Cosmin2106/xmas-drawboard/cad/case/FrontPlate.FCStd

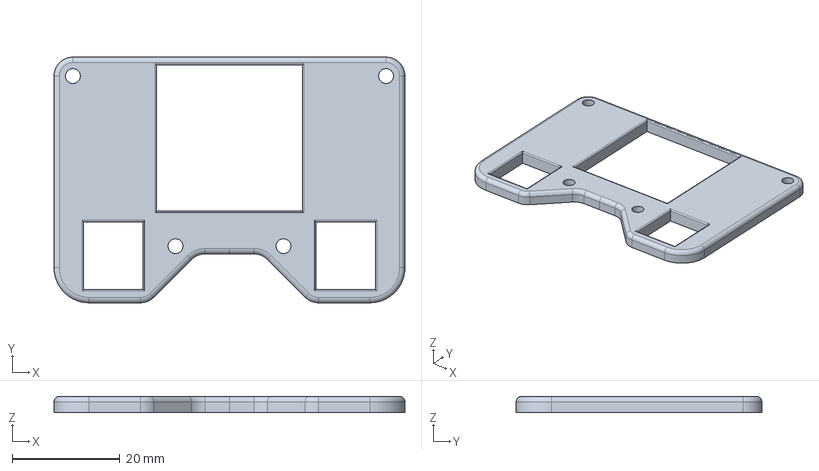
[picture p1: CAD file, 2026-11-04]
cad/case/FrontPlate.FCStd
65.0 x 45.5 x 3.00 mm
