Cosmin2106/xmas-drawboard/cad/case/BackPlate.FCStd

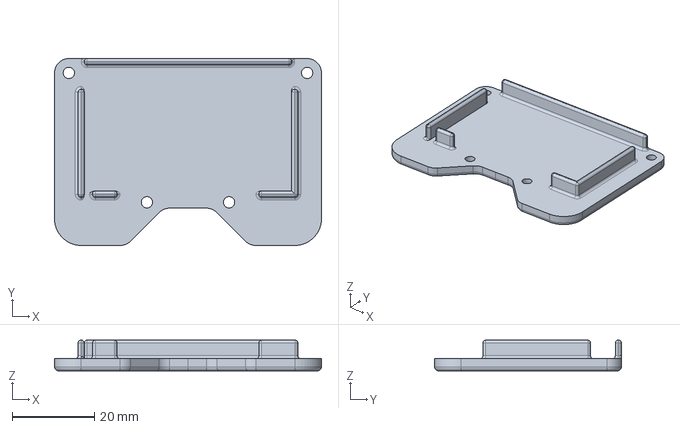
[picture p2: CAD file, 2026-11-04]
cad/case/BackPlate.FCStd
65.0 x 45.5 x 7.50 mm
