Cosmin2106/xmas-drawboard/cad/board/board.kicad_pcb

## KiCad design cad/board/board.kicad_pcb (2026-11-04)

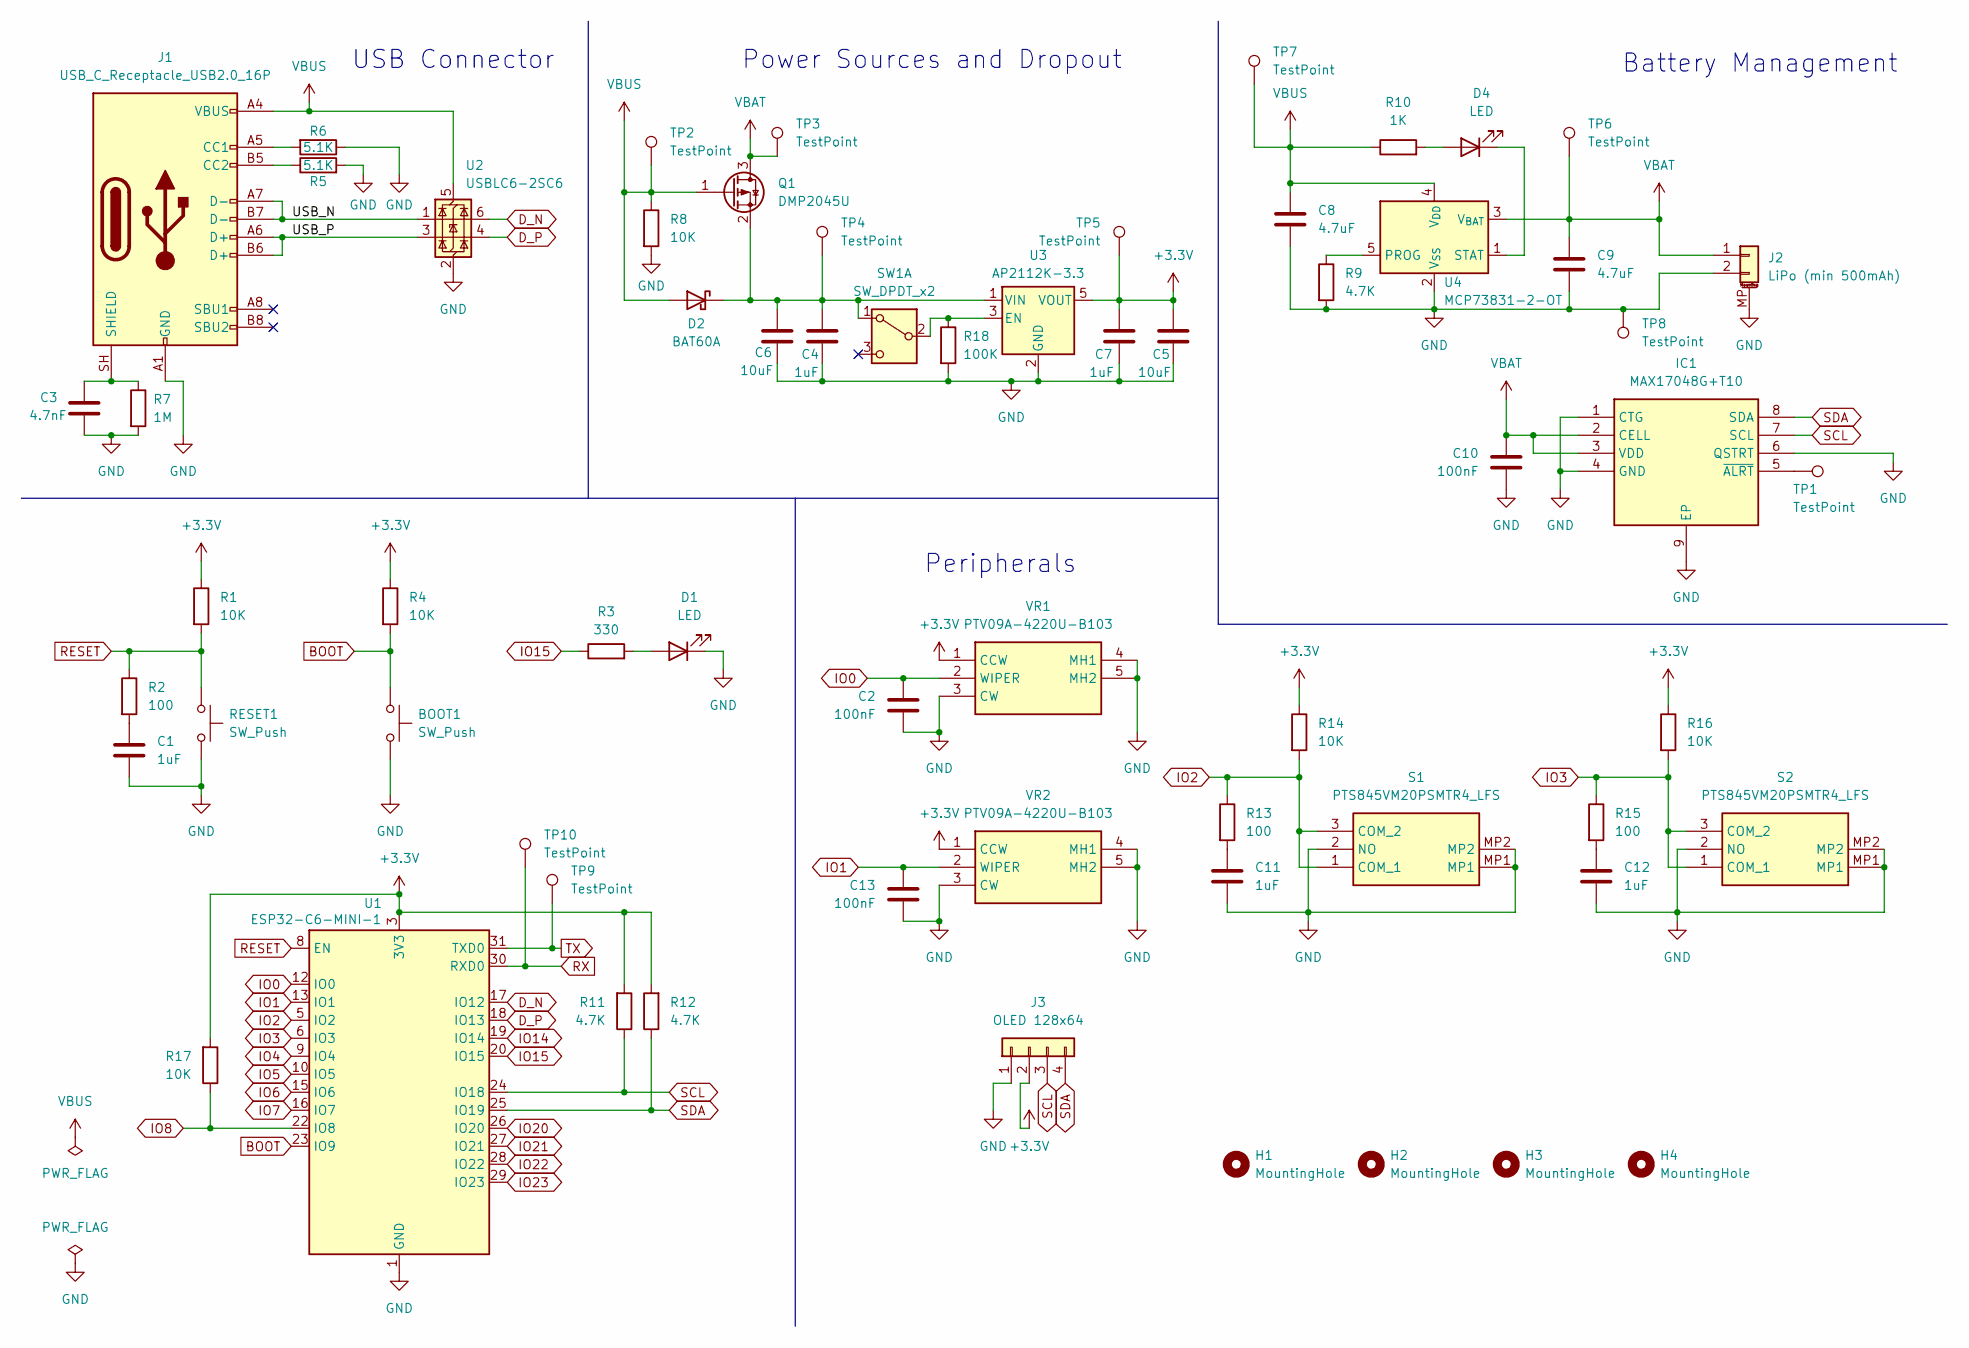
[picture p3: schematic board.kicad_sch, ESP32C6 Drawboard]

Parts:
BOOT1: SW_Push; SW_Push_1P1T_NO_CK_KMR2
C1, C4, C7, C11, C12: 1uF; C_0603_1608Metric
C2, C10, C13: 100nF; C_0603_1608Metric
C3: 4.7nF; C_0603_1608Metric
C5, C6: 10uF; C_0603_1608Metric
C8, C9: 4.7uF; C_0603_1608Metric
D1, D4: LED; LED_0603_1608Metric
D2: BAT60A; D_SOD-323
H1, H2, H3, H4: MountingHole; RPi_Mounting_Hole
IC1: MAX17048G+T10; SON50P200X200X80-9N-D; Mouser Part Number 700-MAX17048G+T10
J1: USB_C_Receptacle_USB2.0_16P; USB_C_Receptacle_GCT_USB4105-xx-A_16P_TopMnt_Horizontal
J2: LiPo (min 500mAh); JST_PH_S2B-PH-SM4-TB_1x02-1MP_P2.00mm_Horizontal
J3: OLED 128x64; OLED_128x64_I2C_BOARD
Q1: DMP2045U; TSOT-23
R1, R4, R8, R14, R16, R17: 10K; R_0603_1608Metric
R2, R13, R15: 100; R_0603_1608Metric
R3: 330; R_0603_1608Metric
R5, R6: 5.1K; R_0603_1608Metric
R7: 1M; R_0603_1608Metric
R9, R11, R12: 4.7K; R_0603_1608Metric
R10: 1K; R_0603_1608Metric
R18: 100K; R_0603_1608Metric
RESET1: SW_Push; SW_Push_1P1T_NO_CK_KMR2
S1, S2: PTS845VM20PSMTR4_LFS; PTS845VM20PSMTR4LFS; Manufacturer_Part_Number PTS845VM20PSMTR4 LFS
SW1: SW_DPDT_x2; SW_SPDT_CK_JS102011SAQN
TP1, TP2, TP3, TP4, TP5, TP6, TP7, TP8, TP9, TP10: TestPoint; TestPoint_Pad_D1.5mm
U1: ESP32-C6-MINI-1
U2: USBLC6-2SC6; SOT-23-6
U3: AP2112K-3.3; SOT-23-5
U4: MCP73831-2-OT; SOT-23-5
VR1, VR2: PTV09A-4220U-B103; PTV09A4220FB103; Mouser Part Number 652-PTV09A-4220FB103

Connections:
+3.3V: C5.1, C7.1, J3.2, R1.1, R4.1, R11.2, R12.2, R14.1, R16.1, R17.2, TP5.1 (1_1), U1.3 (3V3), U3.5 (VOUT), VR1.1 (CCW), VR2.1 (CCW)
/USB_N: J1.A7 (D-), J1.B7 (D-), U2.1 (I/O1)
/USB_P: J1.A6 (D+), J1.B6 (D+), U2.3 (I/O2)
BOOT: BOOT1.1, R4.2, U1.23 (IO9)
D_N: U1.17 (IO12), U2.6 (I/O1)
D_P: U1.18 (IO13), U2.4 (I/O2)
GND: BOOT1.2, C1.2, C2.2, C3.2, C4.2, C5.2, C6.2, C7.2, C8.1, C9.1, C10.2, C11.2, C12.2, C13.2, D1.1 (K), IC1.1 (CTG), IC1.4 (GND), IC1.6 (QSTRT), IC1.9 (EP), J1.A1 (GND), J1.A12 (GND), J1.B1 (GND), J1.B12 (GND), J2.2, J2.MP (MountPin), J3.1, R5.2, R6.1, R7.2, R8.2, R9.2, R18.2, RESET1.2, S1.2 (NO), S1.MP1, S1.MP2, S2.2 (NO), S2.MP1, S2.MP2, TP8.1 (1_1), U1.1 (GND), U1.2 (GND), U1.11 (GND), U1.14 (GND), U1.36 (GND), U1.37 (GND), U1.38 (GND), U1.39 (GND), U1.40 (GND), U1.41 (GND), U1.42 (GND), U1.43 (GND), U1.44 (GND), U1.45 (GND), U1.46 (GND), U1.47 (GND), U1.48 (GND), U1.49 (GND), U1.50 (GND), U1.51 (GND), U1.52 (GND), U1.53 (GND), U2.2 (GND), U3.2 (GND), U4.2 (V_{SS}), VR1.3 (CW), VR1.4 (MH1), VR1.5 (MH2), VR2.3 (CW), VR2.4 (MH1), VR2.5 (MH2)
IO0: C2.1, U1.12 (IO0), VR1.2 (WIPER)
IO1: C13.1, U1.13 (IO1), VR2.2 (WIPER)
IO2: R13.1, R14.2, S1.1 (COM_1), S1.3 (COM_2), U1.5 (IO2)
IO3: R15.1, R16.2, S2.1 (COM_1), S2.3 (COM_2), U1.6 (IO3)
IO4: U1.9 (IO4)
IO5: U1.10 (IO5)
IO6: U1.15 (IO6)
IO7: U1.16 (IO7)
IO8: R17.1, U1.22 (IO8)
IO14: U1.19 (IO14)
IO15: R3.1, U1.20 (IO15)
IO20: U1.26 (IO20)
IO21: U1.27 (IO21)
IO22: U1.28 (IO22)
IO23: U1.29 (IO23)
unnamed: C1.1, R2.2
unnamed: C11.1, R13.2
unnamed: C12.1, R15.2
unnamed: D1.2 (A), R3.2
unnamed: C4.1, C6.1, D2.1 (K), Q1.2 (S), SW1.1 (A), TP4.1 (1_1), U3.1 (VIN)
unnamed: D4.2 (A), R10.2
unnamed: D4.1 (K), U4.1 (STAT)
unnamed: IC1.5 (~ALRT), TP1.1 (1_1)
unnamed: J1.A5 (CC1), R6.2
unnamed: J1.B5 (CC2), R5.1
unnamed: C3.1, J1.SH (SHIELD), R7.1
unnamed: R18.1, SW1.2 (B), U3.3 (EN)
unnamed: R9.1, U4.5 (PROG)
RESET: R1.2, R2.1, RESET1.1, U1.8 (EN)
RX: TP10.1 (1_1), U1.30 (RXD0)
SCL: IC1.7 (SCL), J3.3, R11.1, U1.24 (IO18)
SDA: IC1.8 (SDA), J3.4, R12.1, U1.25 (IO19)
TX: TP9.1 (1_1), U1.31 (TXD0)
VBAT: C9.2, C10.1, IC1.2 (CELL), IC1.3 (VDD), J2.1, Q1.3 (D), TP3.1 (1_1), TP6.1 (1_1), U4.3 (V_{BAT})
VBUS: C8.2, D2.2 (A), J1.A4 (VBUS), J1.A9 (VBUS), J1.B4 (VBUS), J1.B9 (VBUS), Q1.1 (G), R8.1, R10.1, TP2.1 (1_1), TP7.1 (1_1), U2.5 (VBUS), U4.4 (V_{DD})

Notes on the sheet:
USB Connector
Battery Management
Power Sources and Dropout
Peripherals

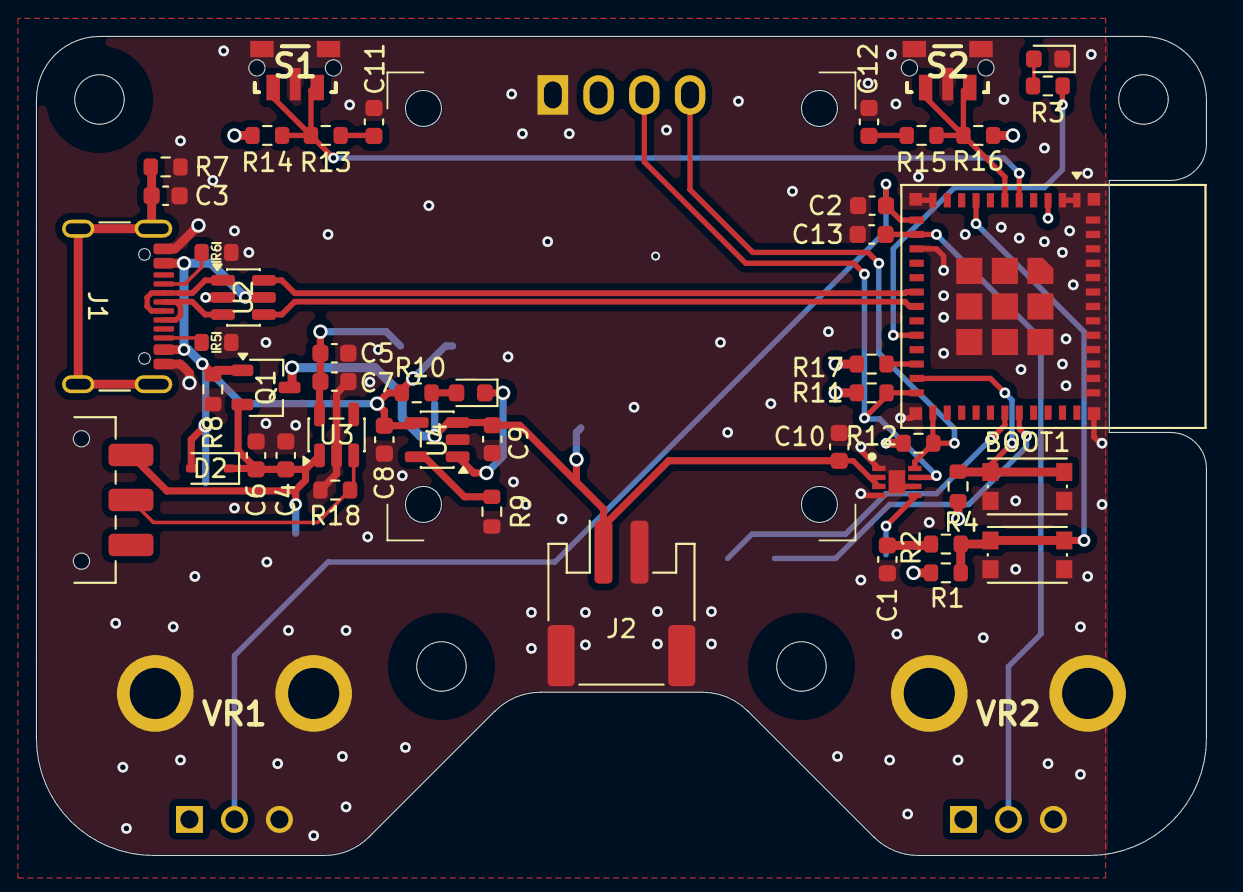
[picture p4: board board.kicad_pcb from above]

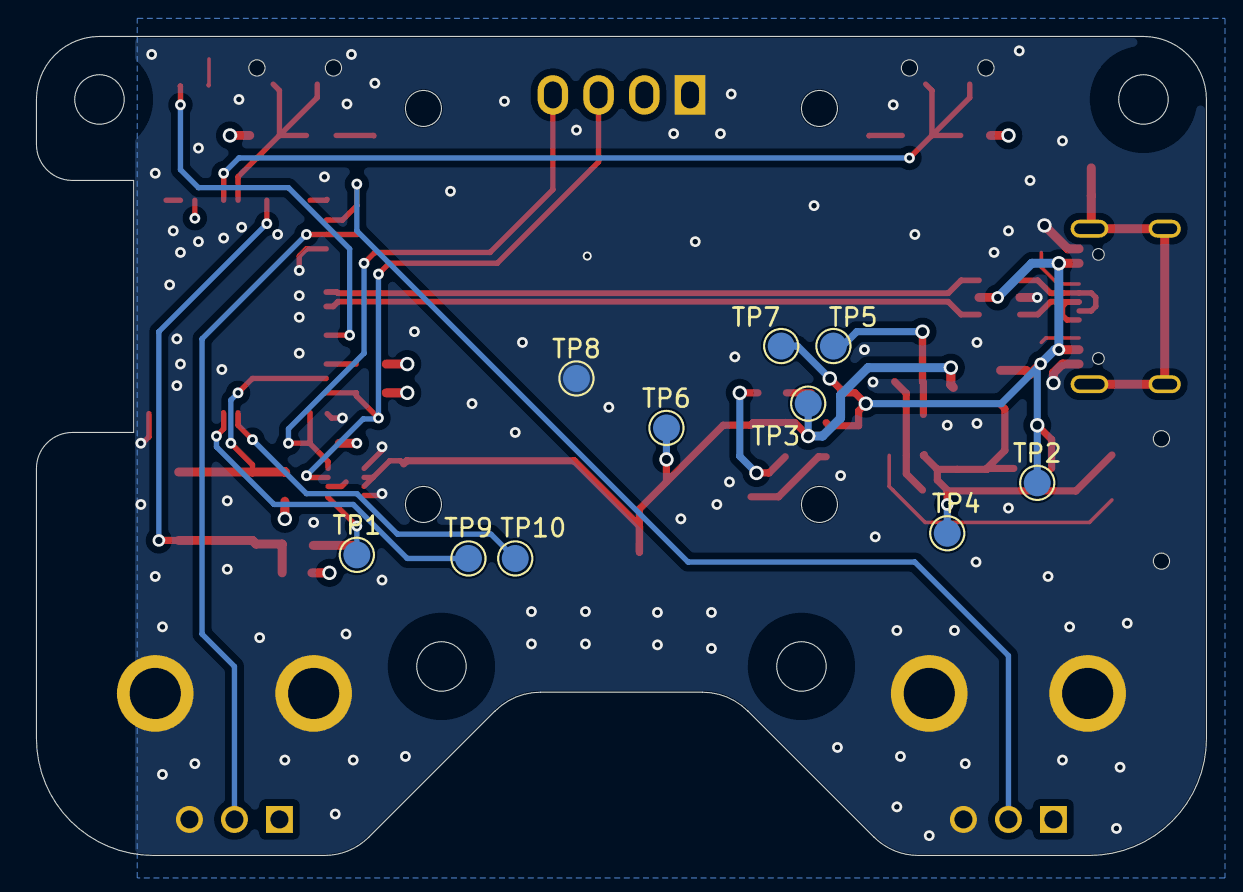
[picture p5: board board.kicad_pcb from below]

Board: 4 copper layers, 65.0 x 45.5 mm, 64 parts (10 on the bottom side), 33 nets.
