Cosmin2106/xmas-drawboard/(commit log)

2026-10-28 Add PCB files and setup repo structure
    [board.kicad_pcb, board.kicad_sch]
2026-10-29 Add display driver template using custom HAL for SSD1315
2026-10-29 Fix HAL issues when driving OLED
    [firmware.c, hal.c, hal.h]
2026-10-30 Extend board to include new peripherals
    [board.kicad_pcb, board.kicad_sch]
2026-11-01 Add all required peripherals and adjust layout
    [board.kicad_pcb, board.kicad_sch]
2026-11-01 Adjust programming resistor value of BMS
    [board.kicad_pcb, board.kicad_sch]
2026-11-02 Add missing decoupling caps and pull-up on IO8
    [board.kicad_pcb, board.kicad_sch]
2026-11-02 Adjust via sizes
    [board.kicad_pcb, board.kicad_sch]
2026-11-02 Thicken some traces
    [board.kicad_pcb]
2026-11-02 Adjust placement of some components
    [board.kicad_pcb]
2026-11-02 Adjust battery gauge position
    [board.kicad_pcb]
2026-11-03 Rewire switch to EN pin of LDO and update BOM
    [board.kicad_pcb, board.kicad_sch]
2026-11-03 Create front plate and free up space around mounting holes
    [FrontPlate.FCStd, board.kicad_pcb]
2026-11-03 Remove CAD backup file
2026-11-04 Add back plate and adjust layout to fit battery
    [BackPlate.FCStd, FrontPlate.FCStd, board.kicad_pcb]
2026-11-04 Update component links
    [board.kicad_sch]
